bjaan/AMPi-Display/label-back.docx

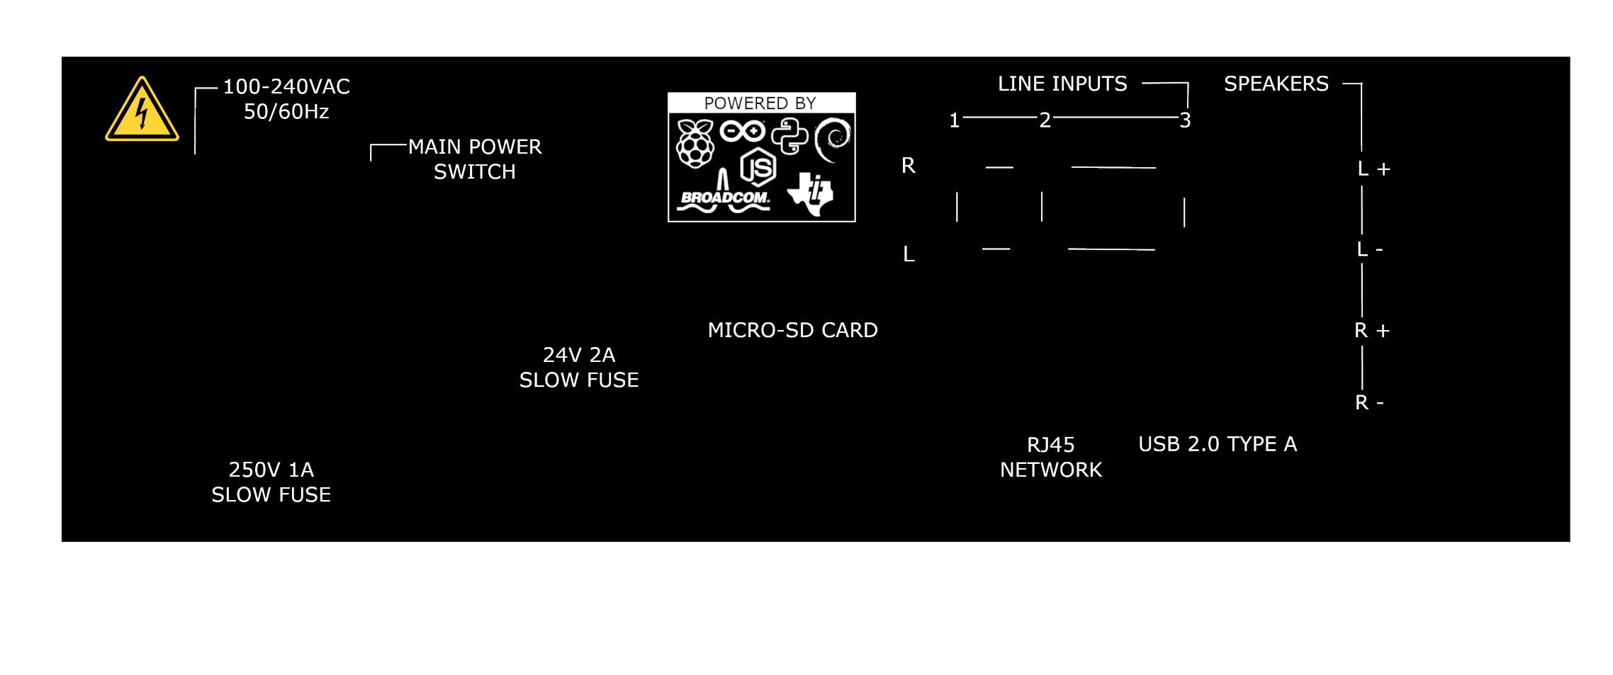
[picture p5: figure]
