bjaan/AMPi-Display/label-front.docx

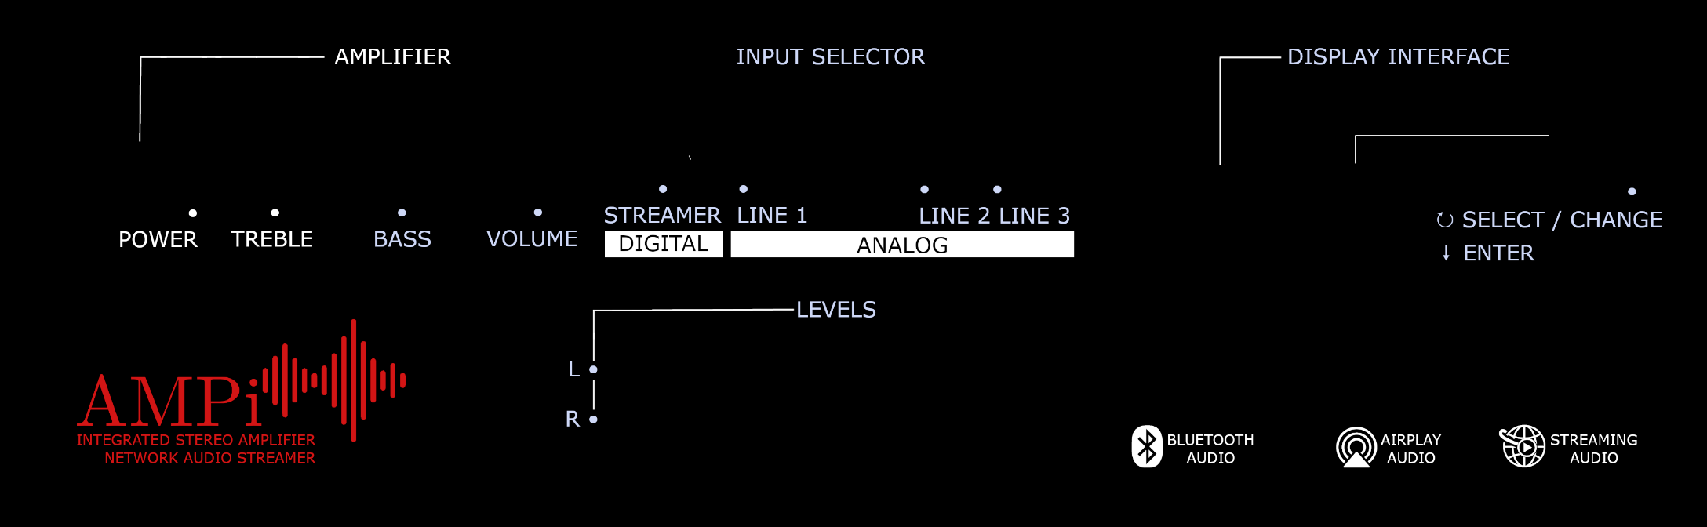
[picture p6: figure]
