bjaan/AMPi-Display/(commit log)

2021-04-25 First version without any icons ands power control for the Pi
2021-04-27 First communications with the Raspberry Pi
2021-04-28 Fix for button status
    [AMPi-Display-Interface.ino]
2021-04-30 Memory wise enhancements & better receive loop (currently broken) & airplay status
    [AMPi-Display-Interface.ino]
2021-04-30 Fixed serial reading & airplay status works
    [AMPi-Display-Interface.ino]
2021-05-04 Added raspberry pi poweroff functionality
2021-05-05 Beginnings of a popup GUI to confirm power up
2021-05-07 Update AMPi-Display-Interface.ino
    Better gradients
    More compact code files linked lists
    Some improvements in the popup GUI - initially used for power on confirmation
2021-05-17 Graphics updates reworked with render queue rather than not-current-flags & updated readme
    [AMPi-Display-Interface.ino]
2021-05-17 Reduce SRAM usage by using smaller char buffers for fixed texts
    [AMPi-Display-Interface.ino]
2021-05-30 fix overflow in set status & readd render pipe double addition protection
    [AMPi-Display-Interface.ino]
2021-06-08 fix the red pixel during cover art display
    [AMPi-Display-Interface.ino]
